humanHardDrive/MatrixPanel/Layout/Dot Display/Dot Display.kicad_pcb

## KiCad design Layout/Dot Display/Dot Display.kicad_pcb (2024-03-02)

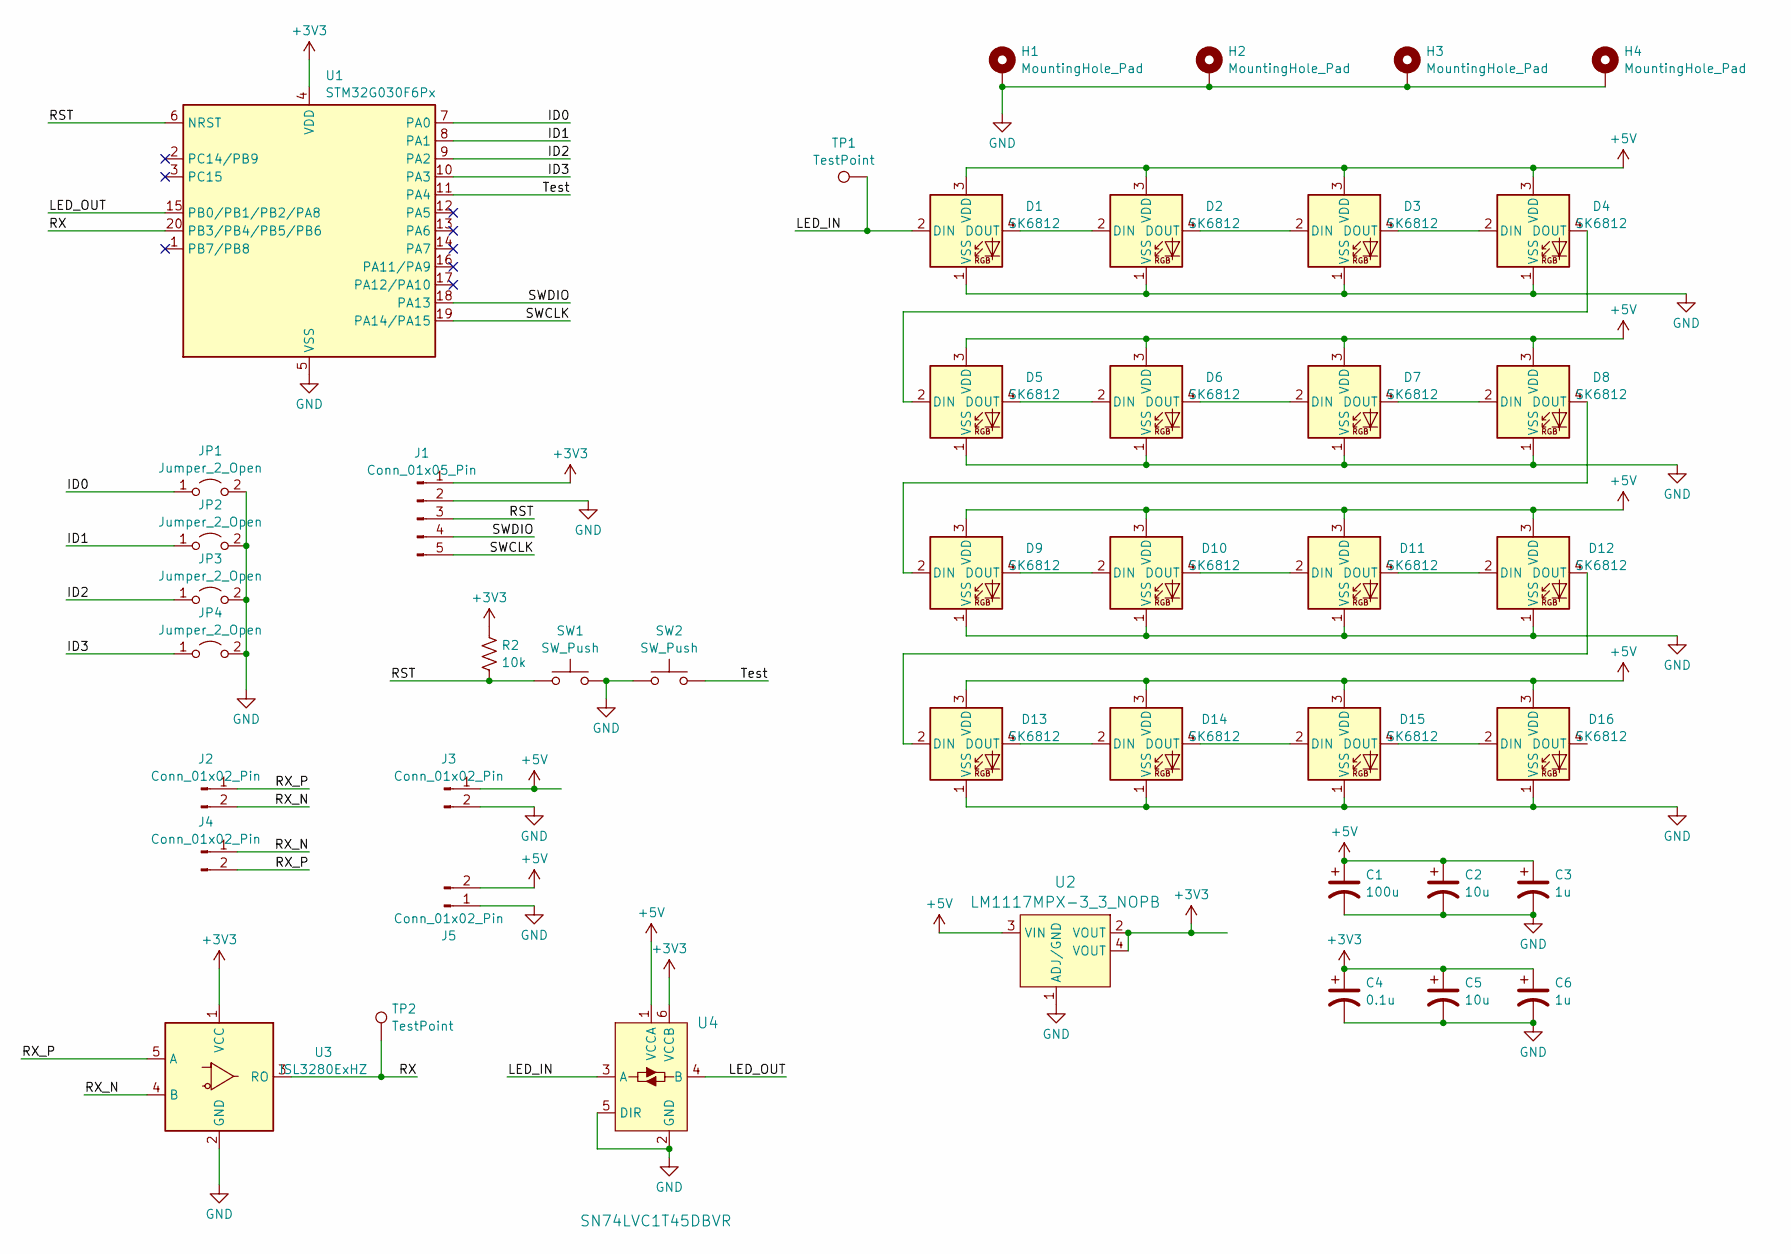
[picture p1: schematic Dot Display.kicad_sch]

Parts:
C1: 100u; C_0805_2012Metric
C2, C5: 10u; C_0805_2012Metric
C3, C6: 1u; C_0805_2012Metric
C4: 0.1u; C_0805_2012Metric
D1, D2, D3, D4, D5, D6, D7, D8, D9, D10, D11, D12, D13, D14, D15, D16: SK6812; LED_SK6812_PLCC4_5.0x5.0mm_P3.2mm
H1, H2, H3, H4: MountingHole_Pad; MountingHole_3.2mm_M3_DIN965_Pad
J1: Conn_01x05_Pin; Harwin_M20-89005xx_1x05_P2.54mm_Horizontal
J2, J3, J4, J5: Conn_01x02_Pin; 23839382
JP1, JP2, JP3, JP4: Jumper_2_Open; SolderJumper-2_P1.3mm_Open_RoundedPad1.0x1.5mm
R2: 10k; R_0805_2012Metric
SW1, SW2: SW_Push; SW_SPST_TL3342
TP1, TP2: TestPoint; TestPoint_Pad_D2.5mm
U1: STM32G030F6Px; TSSOP-20_4.4x6.5mm_P0.65mm
U2: LM1117MPX-3_3_NOPB; SOT-223; MPN LM1117MPX-3.3/NOPB; Digi-Key_PN LM1117MPX-3.3/NOPBCT-ND
U3: ISL3280ExHZ; SOT-23-5
U4: SN74LVC1T45DBVR; SOT-23-6; MPN SN74LVC1T45DBVR; Digi-Key_PN 296-16843-1-ND

Connections:
+3V3: C4.1, C5.1, C6.1, J1.1, R2.1, U1.4 (VDD), U2.2 (VOUT), U2.4 (VOUT), U3.1 (VCC), U4.6 (VCCB)
+5V: C1.1, C2.1, C3.1, D1.3 (VDD), D2.3 (VDD), D3.3 (VDD), D4.3 (VDD), D5.3 (VDD), D6.3 (VDD), D7.3 (VDD), D8.3 (VDD), D9.3 (VDD), D10.3 (VDD), D11.3 (VDD), D12.3 (VDD), D13.3 (VDD), D14.3 (VDD), D15.3 (VDD), D16.3 (VDD), J3.1, J5.2, U2.3 (VIN), U4.1 (VCCA)
/ID0: JP1.1 (A), U1.7 (PA0)
/ID1: JP2.1 (A), U1.8 (PA1)
/ID2: JP3.1 (A), U1.9 (PA2)
/ID3: JP4.1 (A), U1.10 (PA3)
/LED_IN: D1.2 (DIN), TP1.1, U4.3 (A)
/LED_OUT: U1.15 (PB0/PB1/PB2/PA8), U4.4 (B)
/RST: J1.3, R2.2, SW1.1, U1.6 (NRST)
/RX: TP2.1, U1.20 (PB3/PB4/PB5/PB6), U3.3 (RO)
/RX_N: J2.2, J4.1, U3.4 (B)
/RX_P: J2.1, J4.2, U3.5 (A)
/SWCLK: J1.5, U1.19 (PA14/PA15)
/SWDIO: J1.4, U1.18 (PA13)
/Test: SW2.2, U1.11 (PA4)
GND: C1.2, C2.2, C3.2, C4.2, C5.2, C6.2, D1.1 (VSS), D2.1 (VSS), D3.1 (VSS), D4.1 (VSS), D5.1 (VSS), D6.1 (VSS), D7.1 (VSS), D8.1 (VSS), D9.1 (VSS), D10.1 (VSS), D11.1 (VSS), D12.1 (VSS), D13.1 (VSS), D14.1 (VSS), D15.1 (VSS), D16.1 (VSS), H1.1, H2.1, H3.1, H4.1, J1.2, J3.2, J5.1, JP1.2 (B), JP2.2 (B), JP3.2 (B), JP4.2 (B), SW1.2, SW2.1, U1.5 (VSS), U2.1 (ADJ/GND), U3.2 (GND), U4.2 (GND), U4.5 (DIR)
unnamed: D1.4 (DOUT), D2.2 (DIN)
unnamed: D2.4 (DOUT), D3.2 (DIN)
unnamed: D3.4 (DOUT), D4.2 (DIN)
unnamed: D4.4 (DOUT), D5.2 (DIN)
unnamed: D5.4 (DOUT), D6.2 (DIN)
unnamed: D6.4 (DOUT), D7.2 (DIN)
unnamed: D7.4 (DOUT), D8.2 (DIN)
unnamed: D8.4 (DOUT), D9.2 (DIN)
unnamed: D9.4 (DOUT), D10.2 (DIN)
unnamed: D10.4 (DOUT), D11.2 (DIN)
unnamed: D11.4 (DOUT), D12.2 (DIN)
unnamed: D12.4 (DOUT), D13.2 (DIN)
unnamed: D13.4 (DOUT), D14.2 (DIN)
unnamed: D14.4 (DOUT), D15.2 (DIN)
unnamed: D15.4 (DOUT), D16.2 (DIN)

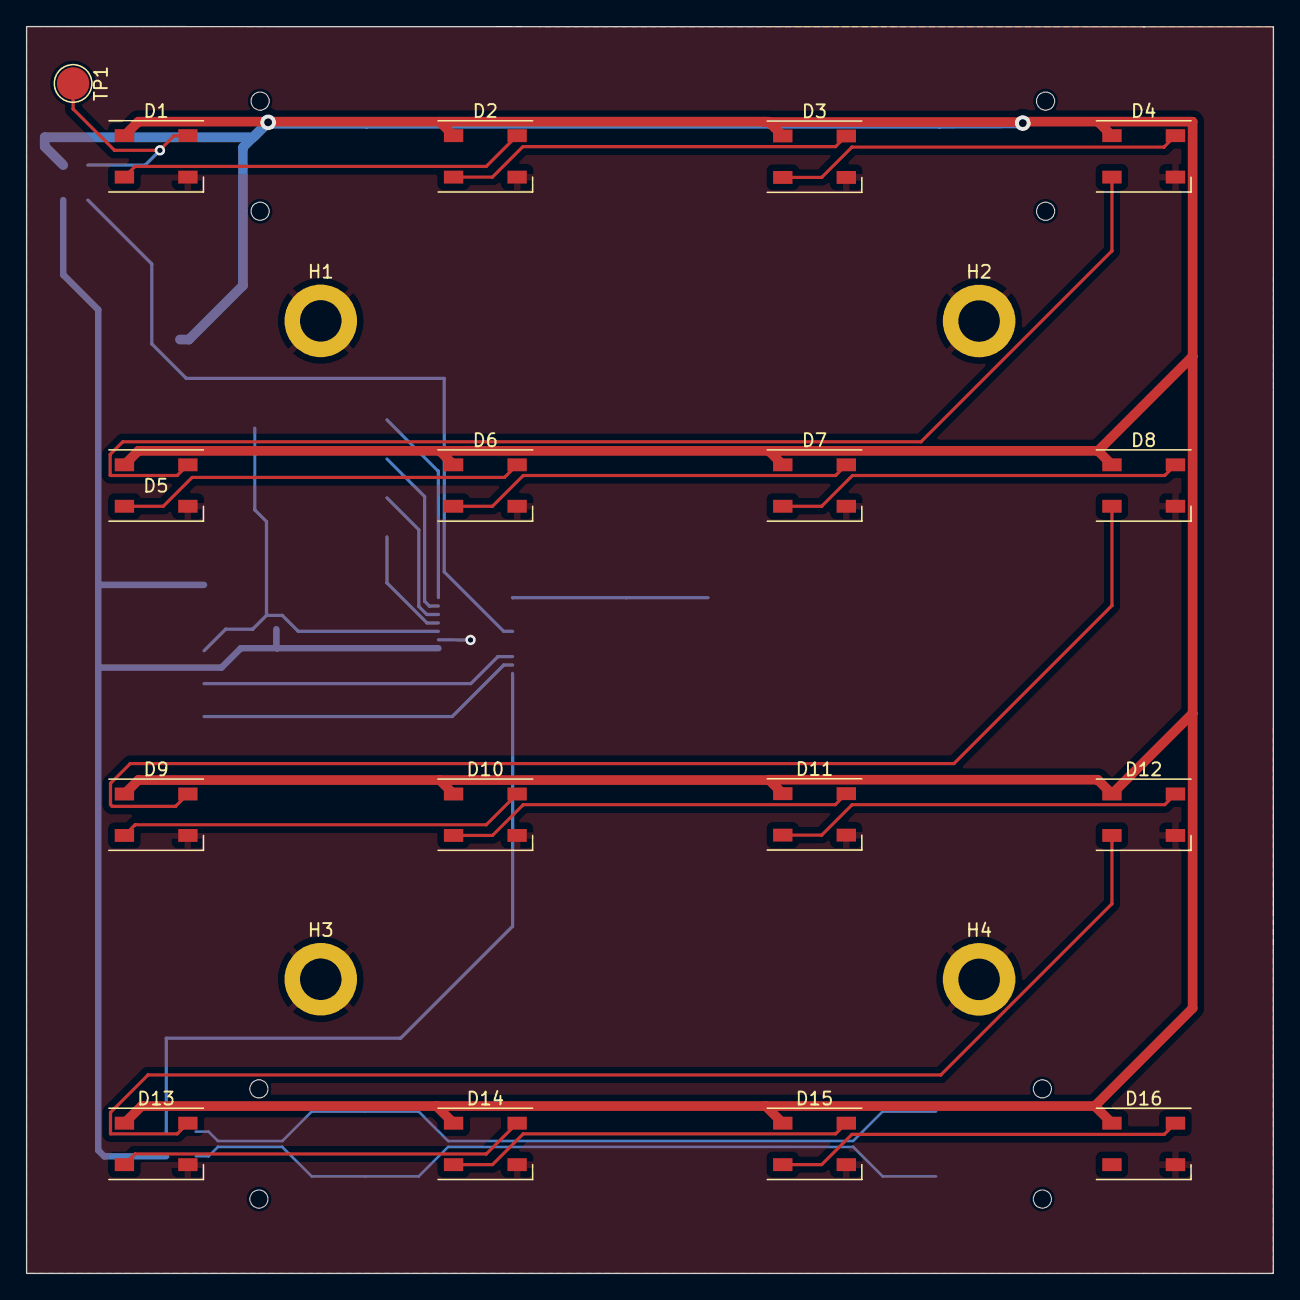
[picture p2: board Dot Display.kicad_pcb from above]

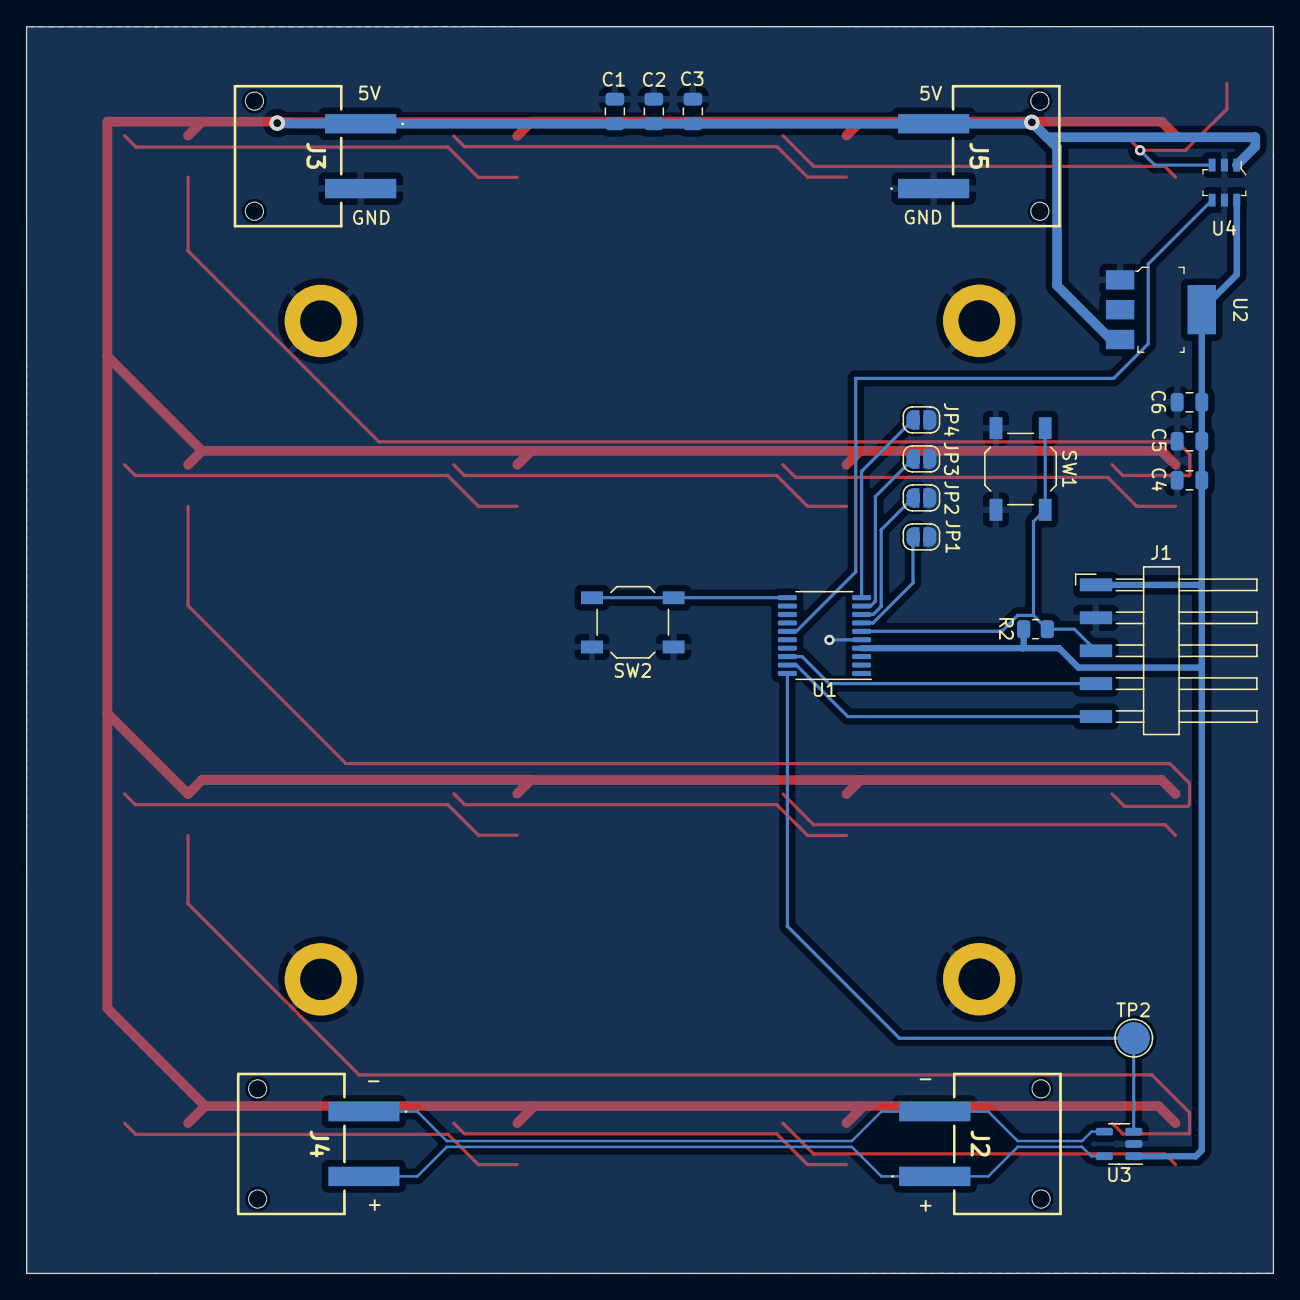
[picture p3: board Dot Display.kicad_pcb from below]

Board: 2 copper layers, 96.2 x 96.2 mm, 44 parts (23 on the bottom side), 31 nets.
