humanHardDrive/MatrixPanel/Code/DotDisplayDriver/Core/Src/main.c

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
/* Includes ------------------------------------------------------------------*/
#include "main.h"

/* USER CODE BEGIN Includes */
#include "SerialComm.h"
#include "LightControl.h"
/* USER CODE END Includes */

TIM_HandleTypeDef htim3;
DMA_HandleTypeDef hdma_tim3_ch3;

UART_HandleTypeDef huart1;

void SystemClock_Config(void);
static void MX_GPIO_Init(void);
static void MX_DMA_Init(void);
static void MX_TIM3_Init(void);
static void MX_USART1_UART_Init(void);
/**
  * @brief  The application entry point.
  * @retval int
  */
int main(void)
{
  /* USER CODE BEGIN 1 */
  uint8_t nDeviceAddress = 0;
  /* USER CODE END 1 */

  /* MCU Configuration--------------------------------------------------------*/

  /* Reset of all peripherals, Initializes the Flash interface and the Systick. */
  HAL_Init();

  /* Configure the system clock */
  SystemClock_Config();

  /* Initialize all configured peripherals */
  MX_GPIO_Init();
  MX_DMA_Init();
  MX_TIM3_Init();
  MX_USART1_UART_Init();
  /* USER CODE BEGIN 2 */
  //Set device address
  if(!HAL_GPIO_ReadPin(GPIOA, ID0_Pin))
	  nDeviceAddress |= 0x01;

  if(!HAL_GPIO_ReadPin(GPIOA, ID1_Pin))
	  nDeviceAddress |= 0x02;

  if(!HAL_GPIO_ReadPin(GPIOA, ID2_Pin))
	  nDeviceAddress |= 0x04;

  if(!HAL_GPIO_ReadPin(GPIOA, ID3_Pin))
	  nDeviceAddress |= 0x08;

  SerialComm_SetDeviceAddress(nDeviceAddress);

  //Setup message handlers
  SerialComm_SetMessageHandler(MSG_TYPE_SET_BUFFER, LightControl_HandleSetBuffer);
  SerialComm_SetMessageHandler(MSG_TYPE_FLIP_BUFFER, LightControl_HandleFlipBuffer);

  //Setup light control
  LightControl_Init(&htim3, TIM_CHANNEL_3);
  /* USER CODE END 2 */

  /* Infinite loop */
  /* USER CODE BEGIN WHILE */
  while (1)
  {
    /* USER CODE END WHILE */

    /* USER CODE BEGIN 3 */
	SerialComm_Background();
	LightControl_Background();
  }
  /* USER CODE END 3 */
}

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
