humanHardDrive/MatrixPanel/Code/DotDisplayDriver/Core/Inc/main.h

#define ID0_Pin GPIO_PIN_0
#define ID0_GPIO_Port GPIOA
#define ID1_Pin GPIO_PIN_1
#define ID1_GPIO_Port GPIOA
#define ID2_Pin GPIO_PIN_2
#define ID2_GPIO_Port GPIOA
#define ID3_Pin GPIO_PIN_3
#define ID3_GPIO_Port GPIOA
#define TestSW_Pin GPIO_PIN_4
#define TestSW_GPIO_Port GPIOA
