humanHardDrive/MatrixPanel/(commit log)

2024-03-02 Initial checkin
    [Dot Display.kicad_pcb, Dot Display.kicad_sch]
2024-03-03 Setup DMA to control light
